itsakhash/balancebot/chassis/img/exploded.png

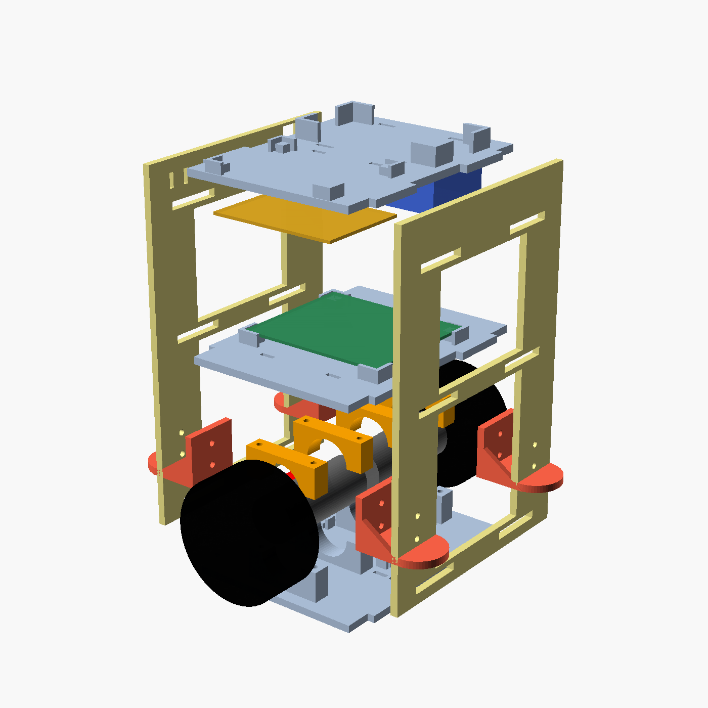
chassis/img/exploded.png
