itsakhash/balancebot/chassis/img/front.png

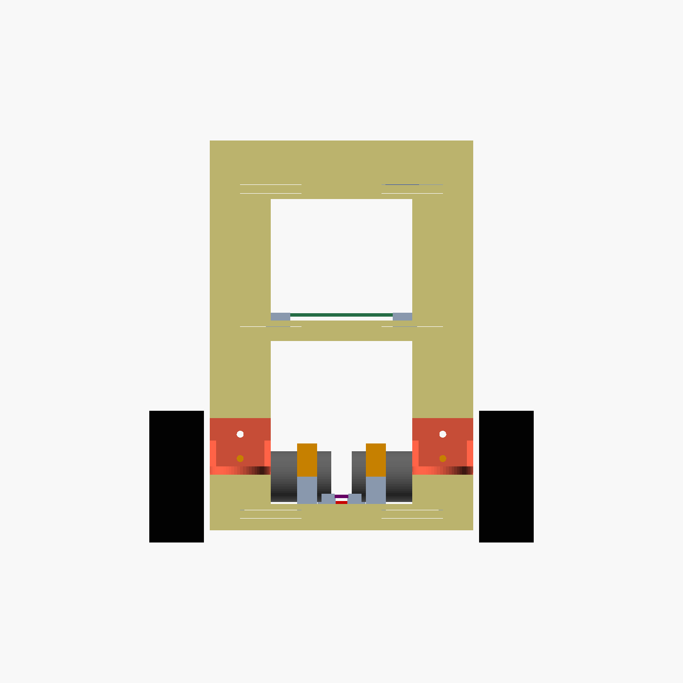
chassis/img/front.png
