itsakhash/balancebot/chassis/img/side.png

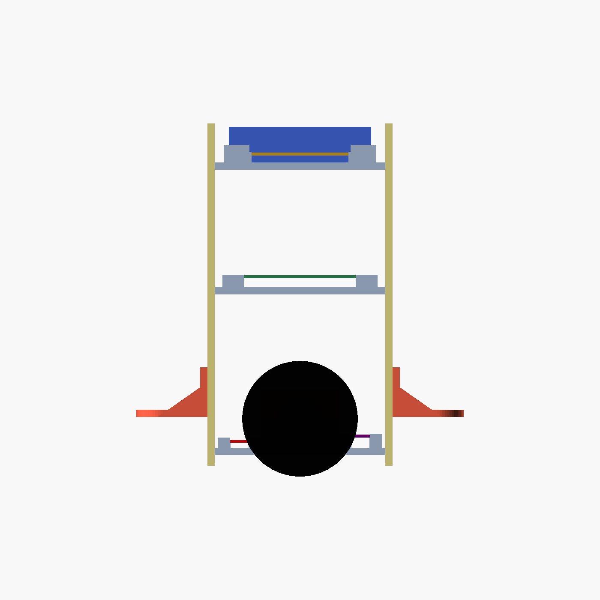
chassis/img/side.png
