itsakhash/balancebot/pendulum_fall.png

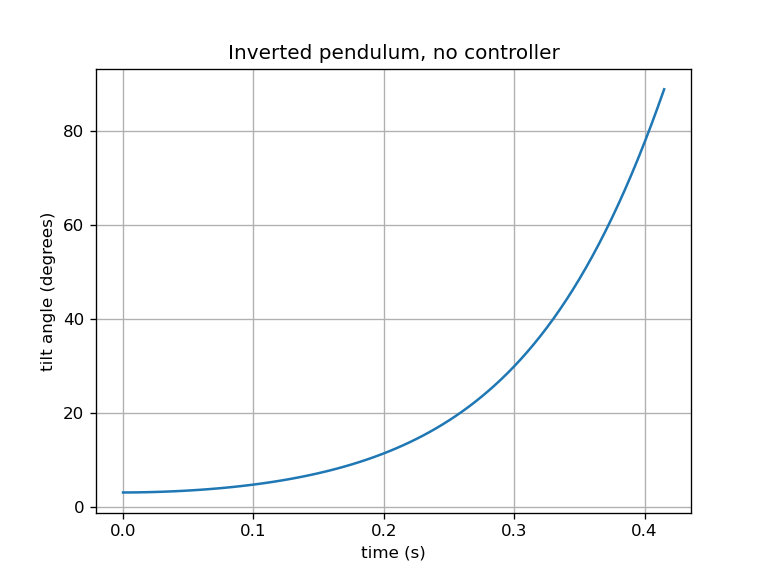
pendulum_fall.png
