itsakhash/balancebot/pid_balance.png

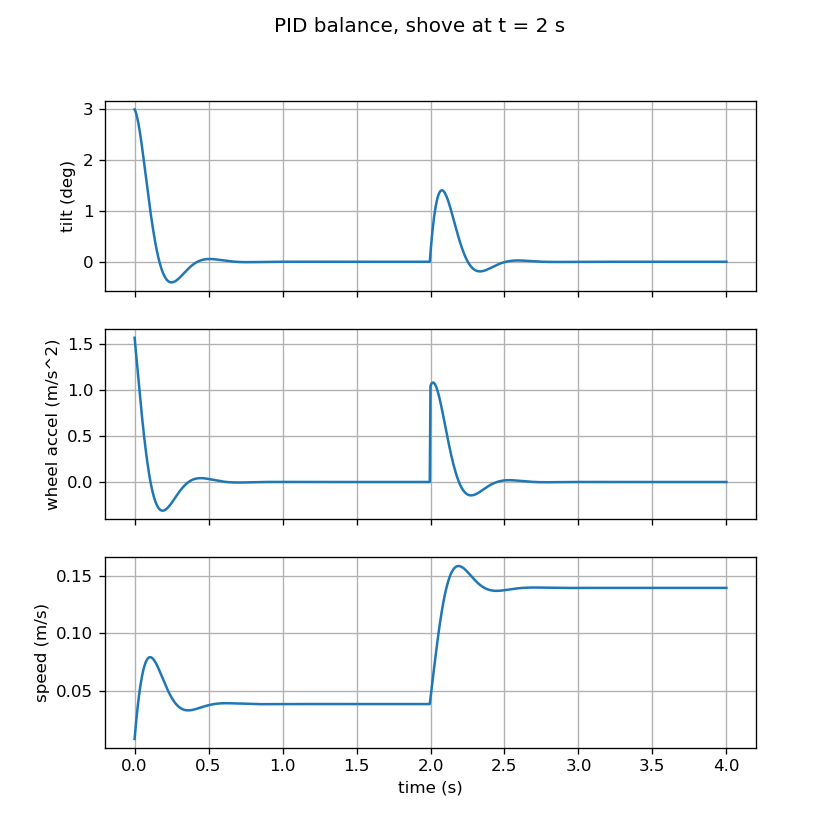
pid_balance.png
