itsakhash/balancebot/chassis/stl/rail_back.stl

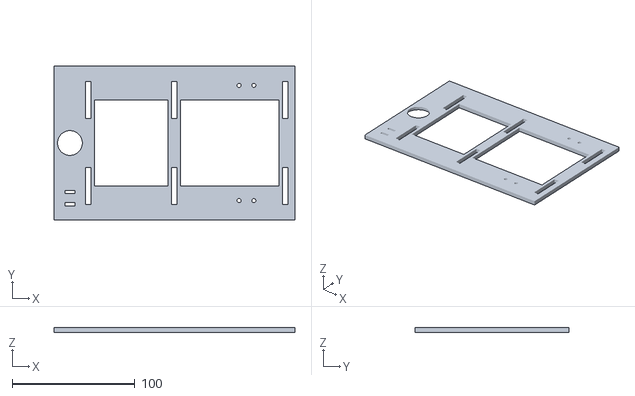
[picture p10: CAD file, 2026-10-22]
chassis/stl/rail_back.stl
196.5 x 125.2 x 4.00
