itsakhash/balancebot/chassis/stl/top_deck.stl

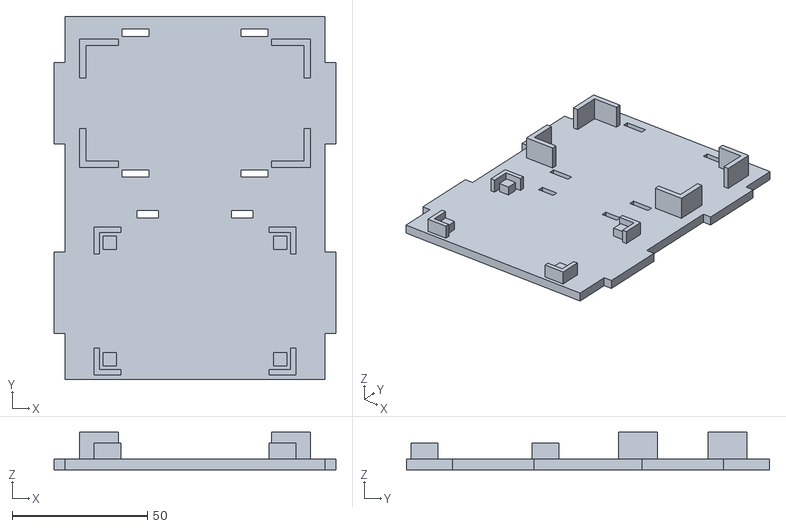
[picture p11: CAD file, 2026-10-22]
chassis/stl/top_deck.stl
104.0 x 134.0 x 14.0
