itsakhash/balancebot/chassis/stl/coupon.stl

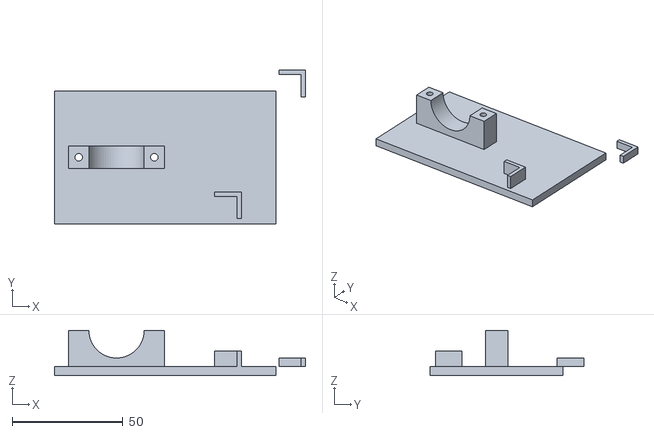
[picture p12: CAD file, 2026-10-22]
chassis/stl/coupon.stl
113.3 x 69.3 x 20.4
