itsakhash/balancebot/chassis/stl/mid_deck.stl

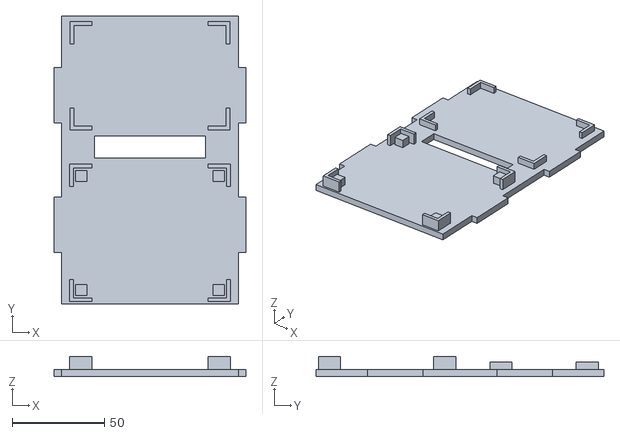
[picture p13: CAD file, 2026-10-22]
chassis/stl/mid_deck.stl
104.0 x 156.0 x 11.0
