itsakhash/balancebot/chassis/stl/cradle_cap.stl

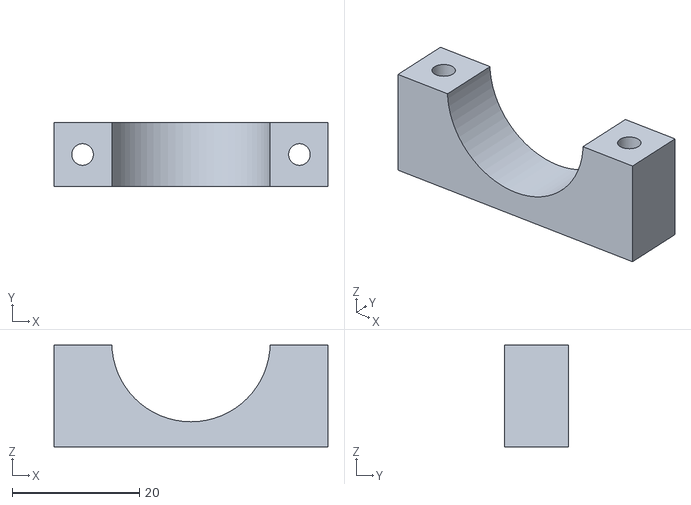
[picture p14: CAD file, 2026-10-22]
chassis/stl/cradle_cap.stl
43.1 x 10.0 x 16.0
