itsakhash/balancebot/chassis/stl/leg.stl

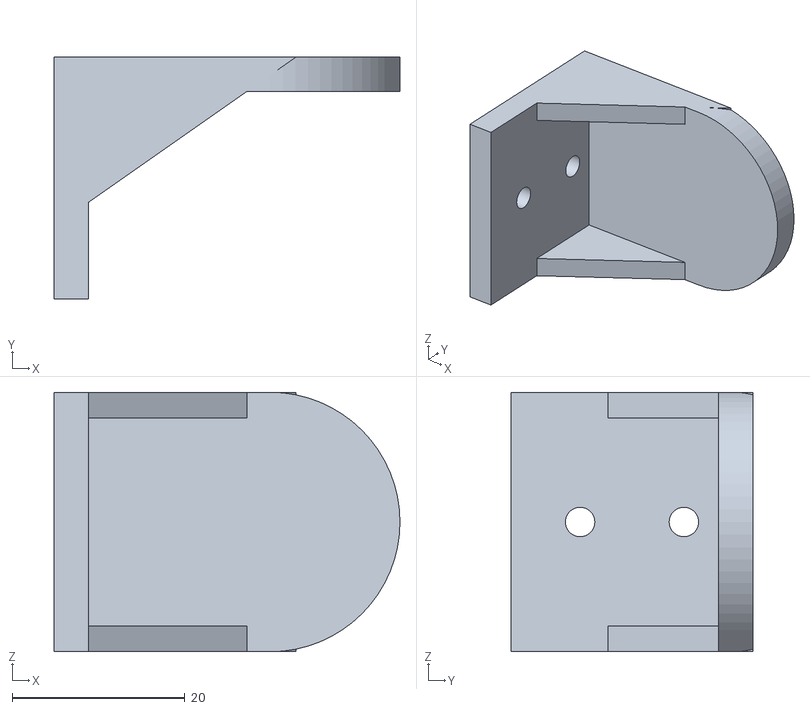
[picture p15: CAD file, 2026-10-22]
chassis/stl/leg.stl
40.0 x 28.0 x 30.0
