itsakhash/balancebot/chassis/stl/base_deck.stl

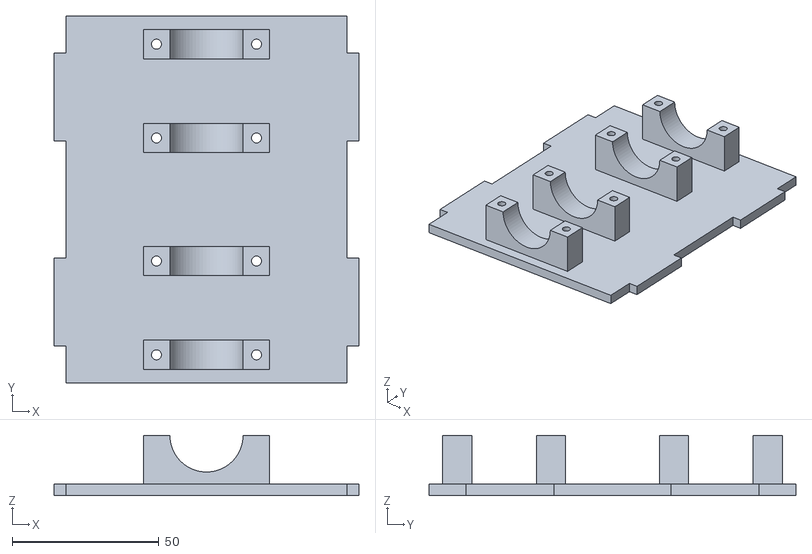
[picture p16: CAD file, 2026-10-22]
chassis/stl/base_deck.stl
104.0 x 125.2 x 20.5
