itsakhash/balancebot/chassis/stl/rail_front.stl

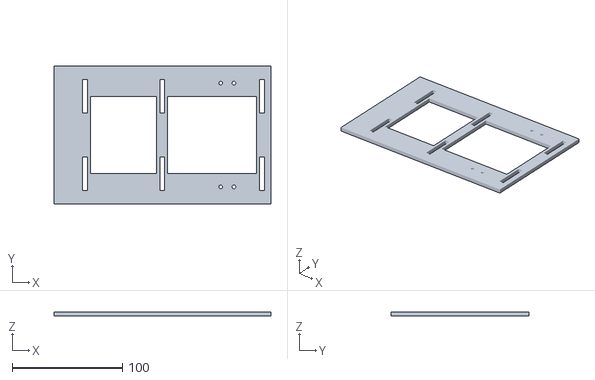
[picture p17: CAD file, 2026-10-22]
chassis/stl/rail_front.stl
196.5 x 125.2 x 4.00
