itsakhash/balancebot/chassis/stl/stand.stl

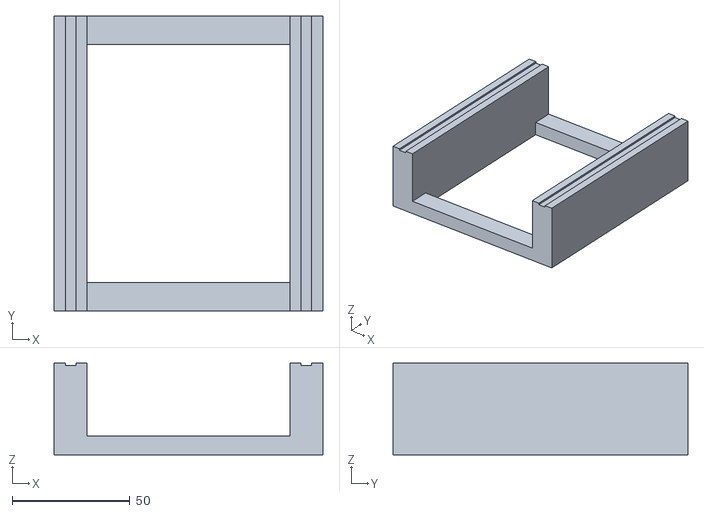
[picture p18: CAD file, 2026-10-21]
chassis/stl/stand.stl
114.0 x 125.2 x 39.0
