itsakhash/balancebot/chassis/img/assembly.png

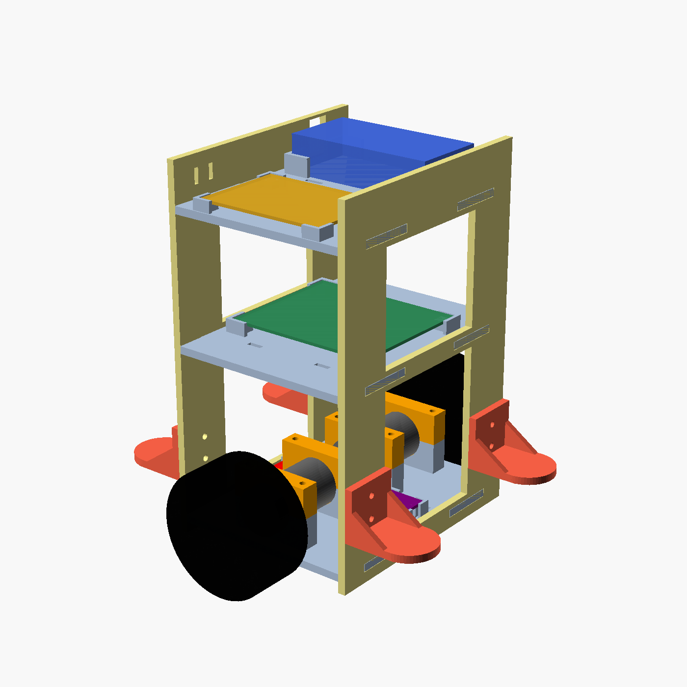
chassis/img/assembly.png
