itsakhash/balancebot/(commit log)

2026-10-08 Phase 1: inverted pendulum simulation, PID tuning, noise and delay sweep
2026-10-08 Add PlatformIO firmware project for NUCLEO-F446RE with LED blink
2026-10-08 Add MPU-6050 I2C driver and serial test (compiles; not yet run on hardware)
2026-10-08 Add complementary filter simulation; README covers tilt estimation and firmware status
2026-10-08 Add LQR state feedback simulation that removes PID drift; update README
2026-10-10 Run tilt estimator on hardware: gyro calibration and complementary filter
2026-10-11 Add motor and encoder drivetrain module with host-tested drive math and bench program
2026-10-11 Add host-tested PID and LQR balance controllers ported from the simulation
2026-10-11 Add parametric OpenSCAD chassis prototype with STLs and fit-test coupon
2026-10-11 Add design_gains: LQR gains for the measured chassis, noisy-sensor and latency studies
2026-10-11 Add motor step-response test and step_fit module; record balance dry-run results
2026-10-11 balance_main: add tilt sign, trim and cut-off settings for bring-up
2026-10-21 set encoder directions from bench test
2026-10-21 chassis updates
2026-10-22 set motor directions from powered bench test
2026-10-22 Move IMU and driver to a mid-deck breadboard, update chassis for measured parts
2026-10-22 Use measured 68.84 mm wheel diameter
